juamorenogo/DCSource_DIY/README.md

# EwigVolt - CV/CC Precision DC Supply

---

Electronic design project / UNAL / 2026-1
Project made by:
* Juan Sebastian Moreno Gonzalez
* Nicolás Prieto Solano

## Design Document

It is disposed a PDF file that contains every single detail of the design of this project.
