juamorenogo/DCSource_DIY/Mechanical-design/README.md

# Diseño Electrónico

En esta carpeta se concentran todos los archivos de diseño, excluyendo aquellos destinados a documentación. Estos archivos pueden clasificarse en las siguientes categorías:

- **Simulaciones eléctricas**  
  Archivos de simulación (SPICE, LTspice, etc.) utilizados para validar el comportamiento del circuito.

- **Propuestas de esquemáticos**  
  Diferentes versiones o iteraciones de los diagramas eléctricos del sistema.

- **Diseño de PCB (layout)**  
  Archivos de ruteo, placement, stackup y reglas de diseño (DRC).

- **Pruebas de prototipado y validación**  
  Resultados de mediciones, capturas de osciloscopio, pruebas funcionales y caracterización.

- **Archivos de fabricación**  
  Gerbers, drill files, pick-and-place y BOM final para producción.

- **Librerías de componentes**  
  Símbolos esquemáticos, footprints y modelos asociados.

- **Modelos y simulaciones avanzadas**  
  Modelos SPICE personalizados, simulaciones térmicas y análisis EMI/EMC.

- **Archivos mecánicos asociados**  
  Modelos CAD (STEP, STL) para integración física del diseño.

- **Control de versiones de hardware**  
  Versiones del diseño organizadas por revisiones (Rev A, Rev B, etc.).

- **Archivos de integración hardware–firmware**  
  Mapas de pines, configuraciones de periféricos y definiciones de señales.

- **Análisis de tolerancias y worst-case**  
  Cálculos y simulaciones considerando variaciones de componentes.

- **Estimaciones y diseño de potencia**  
  Análisis de disipación, eficiencia y dimensionamiento de fuentes.

- **Scripts y automatización de diseño**  
  Herramientas para generación de BOM, validaciones y exportaciones automáticas.

Se dispone a continuacion 

---
### V1.0

---
### V1.1

A

---

### V1.2

B

---
