juamorenogo/DCSource_DIY/General-documentation/README.md

# Documentación general.

En esta carpeta, se dispone toda la documentación utilizada durante el proyecto. Desde esquemas prototipos comerciales, hojas de datos de elementos, propuestas similares dadas por otras personas, entre otros.

Así mismo, se dispone la documentación de desarrollo del prototipo. Este documento condensara toda la información necesaria para la construcción de la fuente, los resultados parciales de cada experimento y demás.
