juamorenogo/DCSource_DIY/Electronic-design/General-Design/PCB/03_Power-supply-Flyback/Flyback_PCB_60Hz/3D/2N3906BU.stp

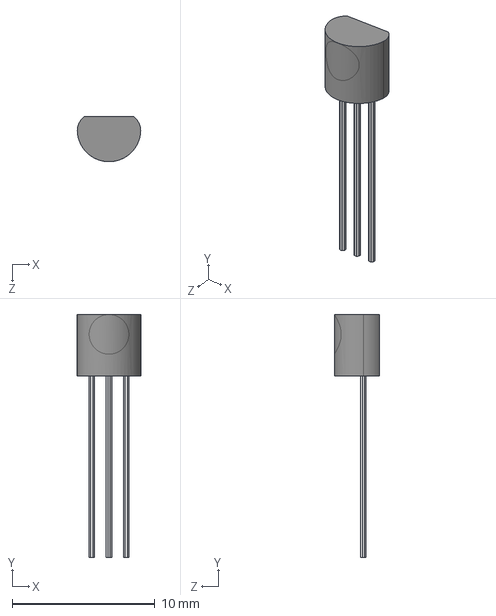
[picture p27: CAD file, 2026-07-27]
Electronic-design/General-Design/PCB/03_Power-supply-Flyback/Flyback_PCB_60Hz/3D/2N3906BU.stp
4.45 x 17.0 x 3.18 mm
