juamorenogo/DCSource_DIY/Electronic-design/General-Design/PCB/03_Power-supply-Flyback/Flyback_PCB_60Hz/3D/Flyback/KBPC610.stp

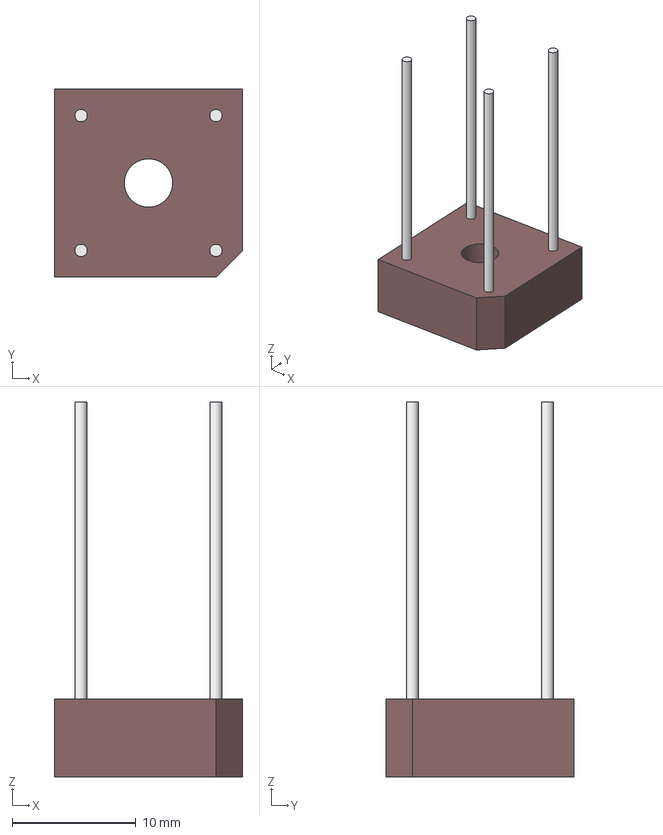
[picture p28: CAD file, 2026-07-27]
Electronic-design/General-Design/PCB/03_Power-supply-Flyback/Flyback_PCB_60Hz/3D/Flyback/KBPC610.stp
15.2 x 15.2 x 30.3 mm
