juamorenogo/DCSource_DIY/Electronic-design/General-Design/PCB/03_Power-supply-Flyback/Flyback_PCB_60Hz/3D/AMRM00101040150MA1.stp

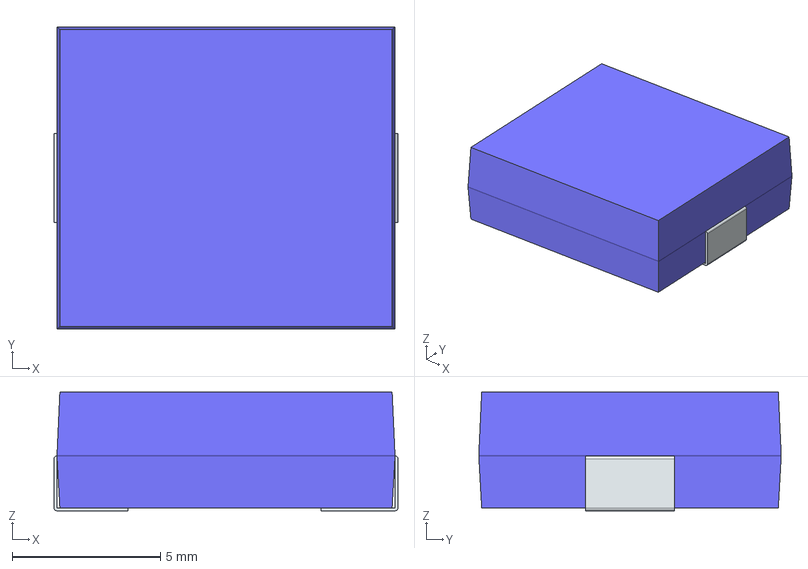
[picture p29: CAD file, 2026-07-12]
Electronic-design/General-Design/PCB/03_Power-supply-Flyback/Flyback_PCB_60Hz/3D/AMRM00101040150MA1.stp
11.6 x 10.2 x 4.00 mm
FilletPin1
FilletPin2
