juamorenogo/DCSource_DIY/Electronic-design/General-Design/PCB/03_Power-supply-Flyback/Flyback_PCB_60Hz/3D/Flyback/TB002-500-02BE.stp

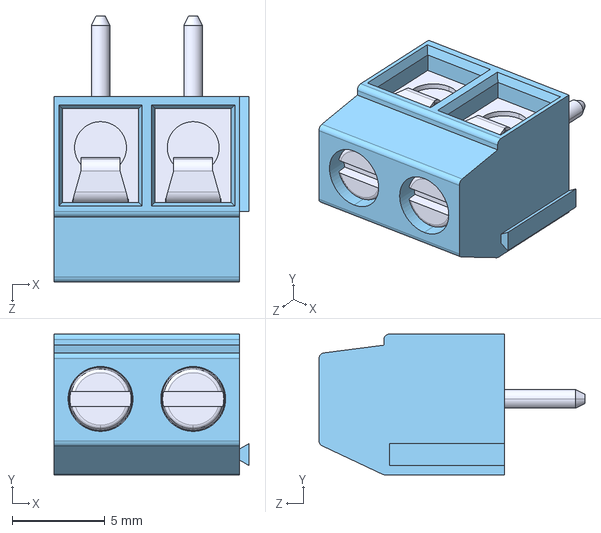
[picture p30: CAD file, 2026-07-27]
Electronic-design/General-Design/PCB/03_Power-supply-Flyback/Flyback_PCB_60Hz/3D/Flyback/TB002-500-02BE.stp
10.5 x 7.60 x 14.4 mm
