juamorenogo/DCSource_DIY/Electronic-design/General-Design/PCB/03_Power-supply-Flyback/Flyback_PCB_60Hz/3D/4300.0104.stp

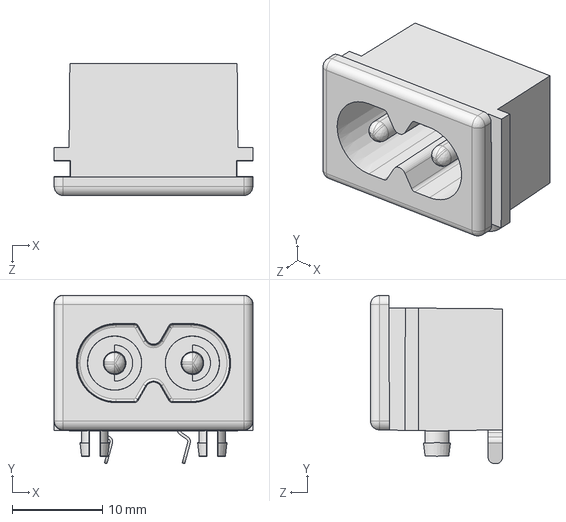
[picture p31: CAD file, 2026-07-12]
Electronic-design/General-Design/PCB/03_Power-supply-Flyback/Flyback_PCB_60Hz/3D/4300.0104.stp
22.0 x 18.6 x 14.6 mm
