juamorenogo/DCSource_DIY/Electronic-design/General-Design/PCB/03_Power-supply-Flyback/Flyback_PCB_60Hz/3D/Flyback/ES3JB-HF.stp

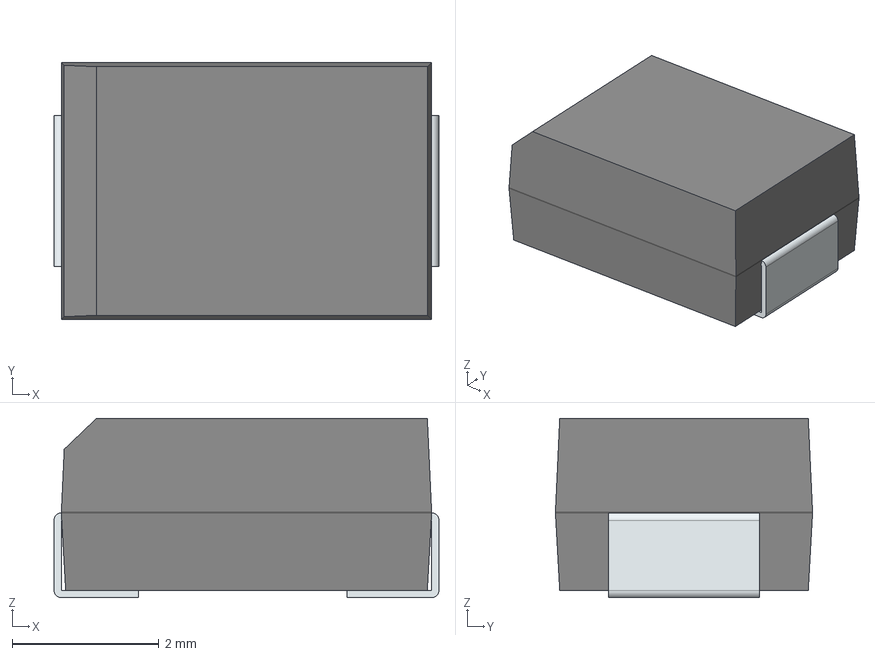
[picture p32: CAD file, 2026-07-27]
Electronic-design/General-Design/PCB/03_Power-supply-Flyback/Flyback_PCB_60Hz/3D/Flyback/ES3JB-HF.stp
5.24 x 3.50 x 2.44 mm
FilletPin1
FilletPin2
