juamorenogo/DCSource_DIY/Electronic-design/General-Design/PCB/03_Power-supply-Flyback/Flyback_PCB_60Hz/3D/Flyback/BFR182E6327HTSA1.stp

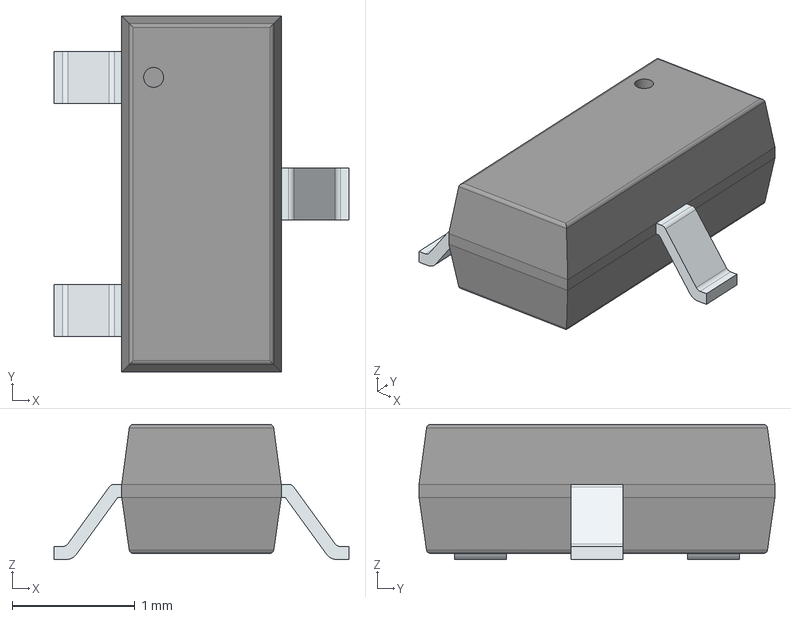
[picture p33: CAD file, 2026-07-27]
Electronic-design/General-Design/PCB/03_Power-supply-Flyback/Flyback_PCB_60Hz/3D/Flyback/BFR182E6327HTSA1.stp
2.40 x 2.90 x 1.10 mm
PinsArrayL
FilletPinR
