juamorenogo/DCSource_DIY/Electronic-design/General-Design/PCB/03_Power-supply-Flyback/Flyback_PCB_60Hz/3D/3FS-324.stp

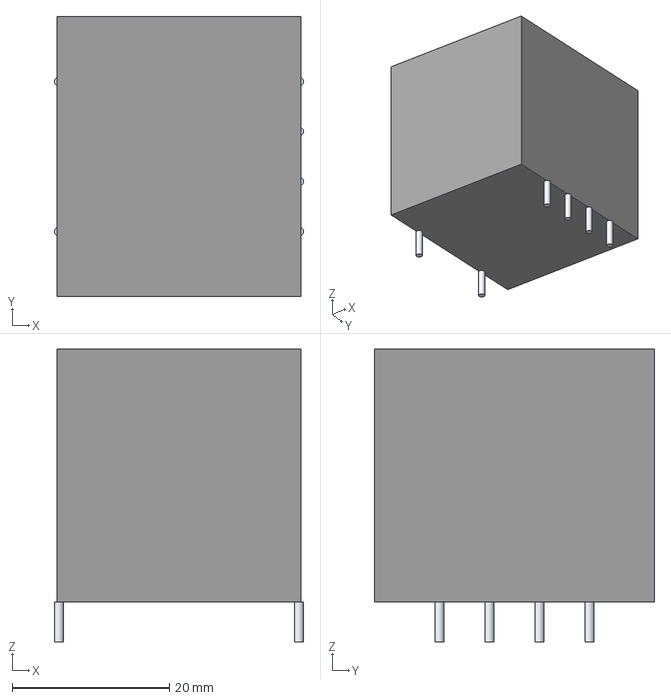
[picture p34: CAD file, 2026-07-12]
Electronic-design/General-Design/PCB/03_Power-supply-Flyback/Flyback_PCB_60Hz/3D/3FS-324.stp
31.6 x 35.6 x 37.2 mm
Leads
