juamorenogo/DCSource_DIY/Electronic-design/General-Design/PCB/03_Power-supply-Flyback/Flyback_PCB_60Hz/3D/Flyback/MPZ1608R391ATD25.stp

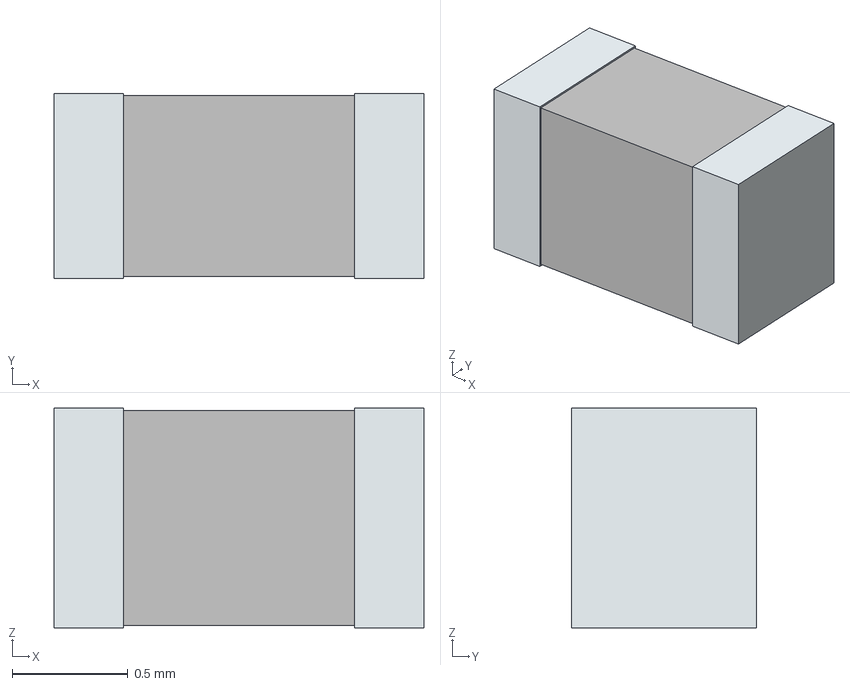
[picture p35: CAD file, 2026-07-23]
Electronic-design/General-Design/PCB/03_Power-supply-Flyback/Flyback_PCB_60Hz/3D/Flyback/MPZ1608R391ATD25.stp
1.60 x 0.8 x 0.95 mm
term1
term2
