juamorenogo/DCSource_DIY/Electronic-design/General-Design/PCB/03_Power-supply-Flyback/Flyback_PCB_60Hz/3D/Flyback/TL431ACLPR.stp

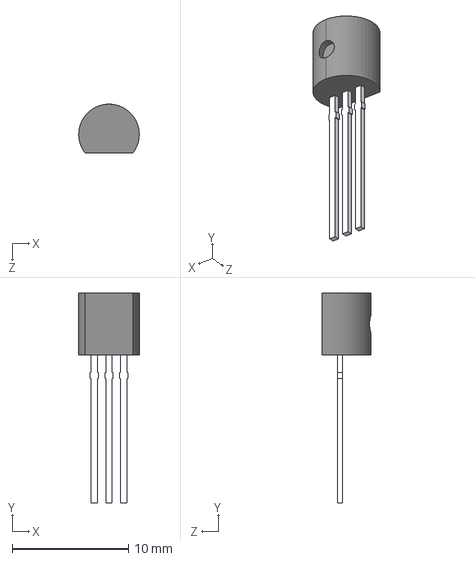
[picture p36: CAD file, 2026-07-23]
Electronic-design/General-Design/PCB/03_Power-supply-Flyback/Flyback_PCB_60Hz/3D/Flyback/TL431ACLPR.stp
5.21 x 18.0 x 4.19 mm
