juamorenogo/DCSource_DIY/Electronic-design/General-Design/PCB/03_Power-supply-Flyback/Flyback_PCB_60Hz/3D/Flyback/UCC38C43DR.stp

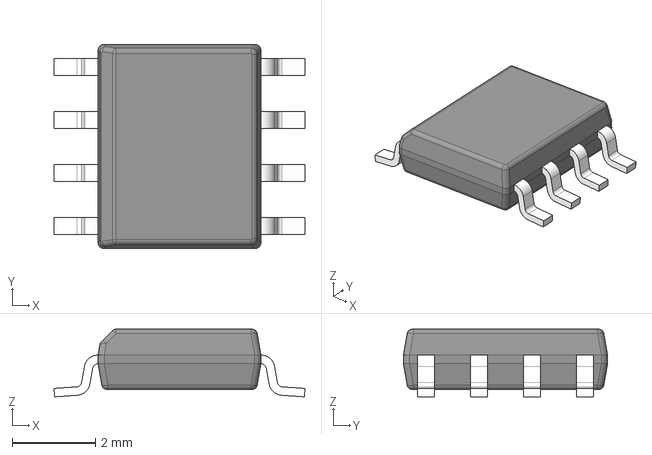
[picture p37: CAD file, 2026-07-23]
Electronic-design/General-Design/PCB/03_Power-supply-Flyback/Flyback_PCB_60Hz/3D/Flyback/UCC38C43DR.stp
6.02 x 4.90 x 1.63 mm
BODY-SO
LEAD-D0008A x 8
