juamorenogo/DCSource_DIY/Electronic-design/General-Design/PCB/03_Power-supply-Flyback/Flyback_PCB_60Hz/3D/Flyback/CSRN2512FKR250.stp

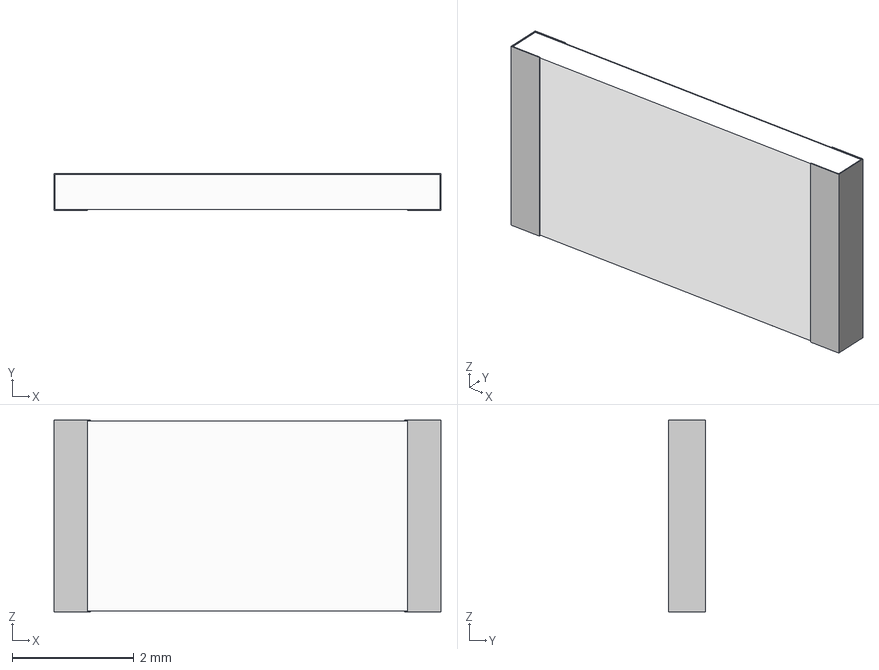
[picture p38: CAD file, 2026-07-23]
Electronic-design/General-Design/PCB/03_Power-supply-Flyback/Flyback_PCB_60Hz/3D/Flyback/CSRN2512FKR250.stp
6.35 x 0.6 x 3.15 mm
