juamorenogo/DCSource_DIY/Electronic-design/General-Design/PCB/03_Power-supply-Flyback/Flyback_PCB_60Hz/3D/Flyback/DPC817L-A-TR.stp

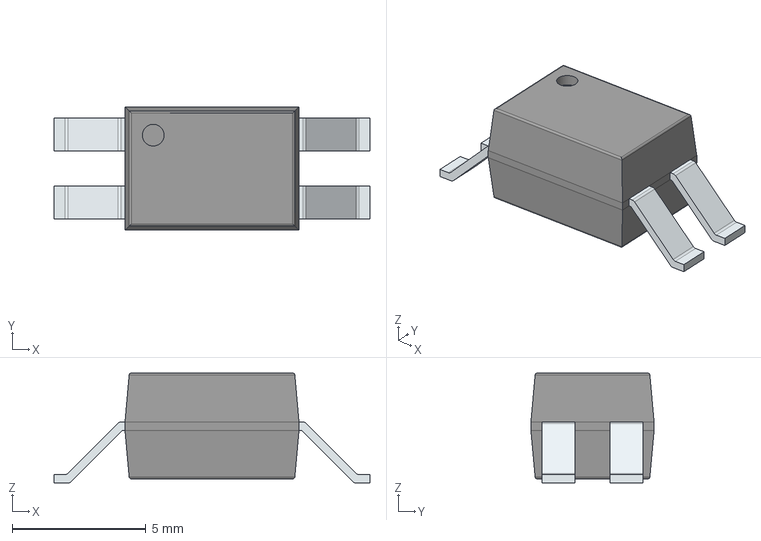
[picture p39: CAD file, 2026-07-23]
Electronic-design/General-Design/PCB/03_Power-supply-Flyback/Flyback_PCB_60Hz/3D/Flyback/DPC817L-A-TR.stp
11.8 x 4.60 x 4.10 mm
PinsArrayLR
