juamorenogo/DCSource_DIY/Electronic-design/General-Design/PCB/03_Power-supply-Flyback/Flyback_PCB_60Hz/3D/TPS54302DDCR.stp

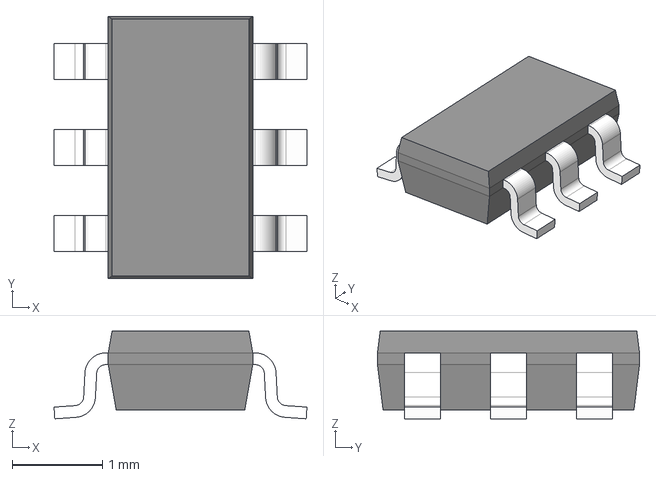
[picture p41: CAD file, 2026-07-12]
Electronic-design/General-Design/PCB/03_Power-supply-Flyback/Flyback_PCB_60Hz/3D/TPS54302DDCR.stp
2.80 x 2.90 x 0.97 mm
BODY-SOT
LEAD-SOT x 6
