juamorenogo/DCSource_DIY/Electronic-design/General-Design/PCB/03_Power-supply-Flyback/Flyback_PCB_60Hz/3D/Flyback/750811351.stp

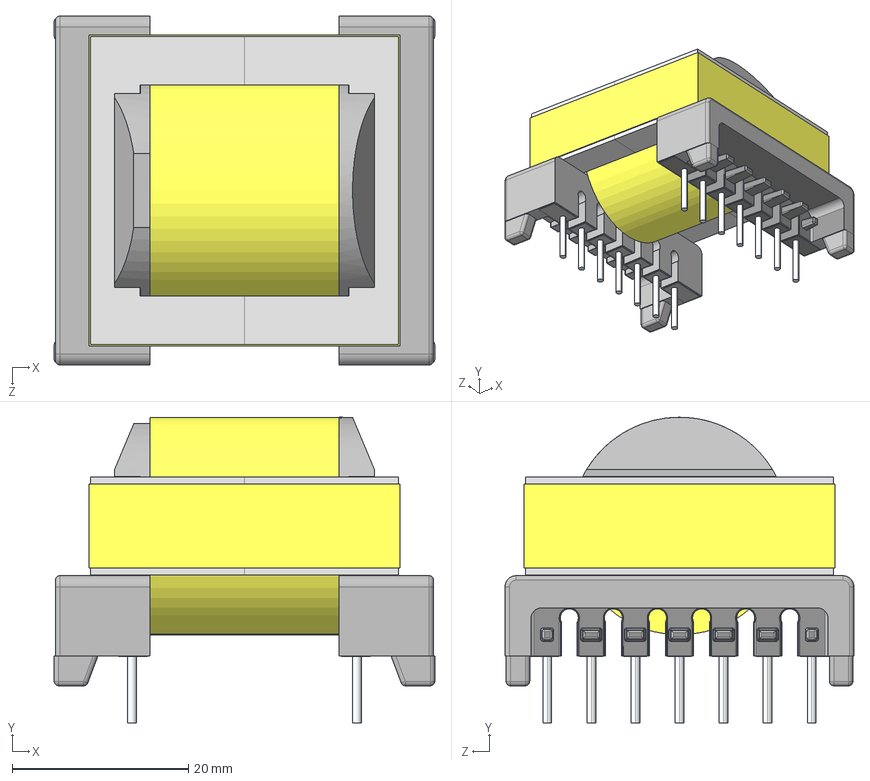
[picture p42: CAD file, 2026-07-23]
Electronic-design/General-Design/PCB/03_Power-supply-Flyback/Flyback_PCB_60Hz/3D/Flyback/750811351.stp
43.2 x 34.7 x 39.6 mm
070-5455_6C
070-5455_coil
150-0897_6C x 2
