juamorenogo/DCSource_DIY/Electronic-design/General-Design/PCB/02_Power-supply/PCB60hz_15/PCB60hz_15-B_Cu.pdf

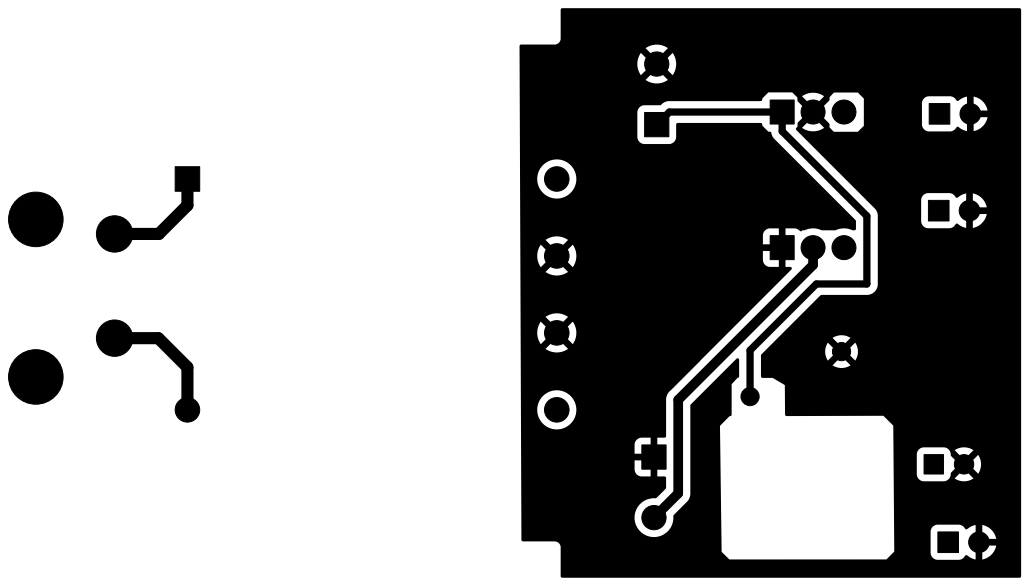
[picture p43: page 1]
