juamorenogo/DCSource_DIY/Electronic-design/General-Design/PCB/02_Power-supply/PCB60hz_15/PCB60hz_15-Edge_Cuts.pdf

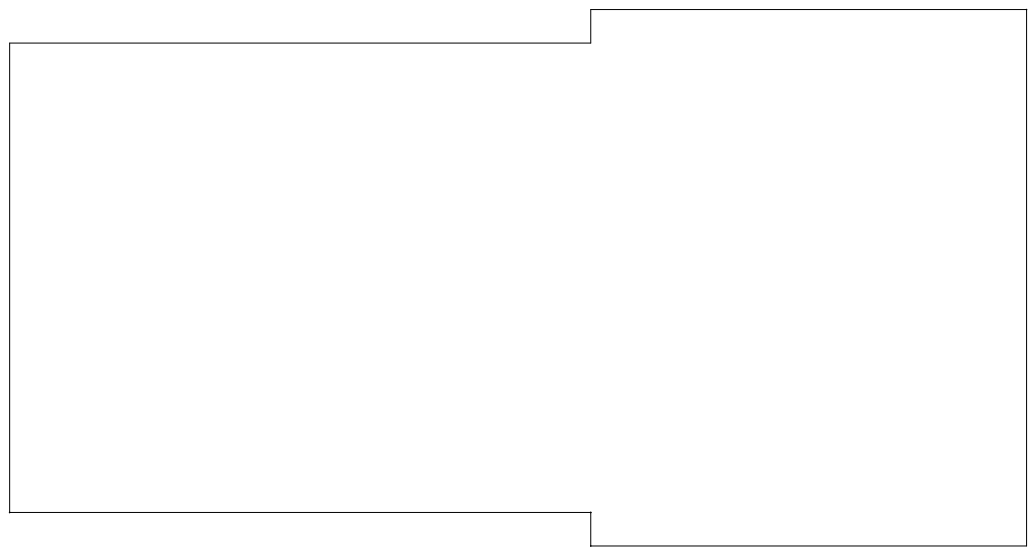
[picture p44: page 1]
