juamorenogo/DCSource_DIY/Electronic-design/General-Design/PCB/02_Power-supply/PCB60hz_15/PCB60hz_15-F_Cu.pdf

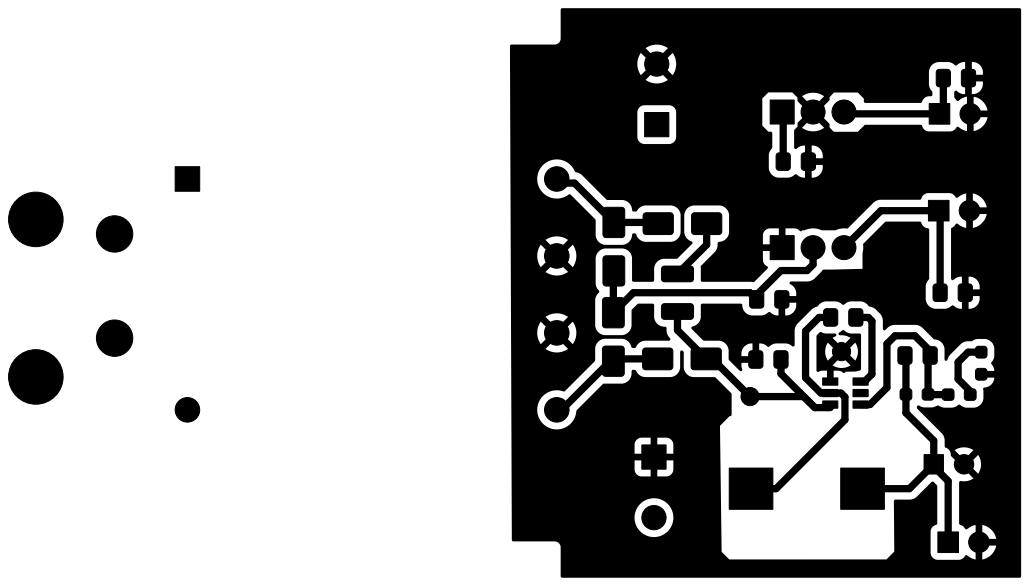
[picture p45: page 1]
