juamorenogo/DCSource_DIY/Electronic-design/General-Design/PCB/02_Power-supply/PCB60hz_15/PCB60hz_15-F_Silkscreen.pdf

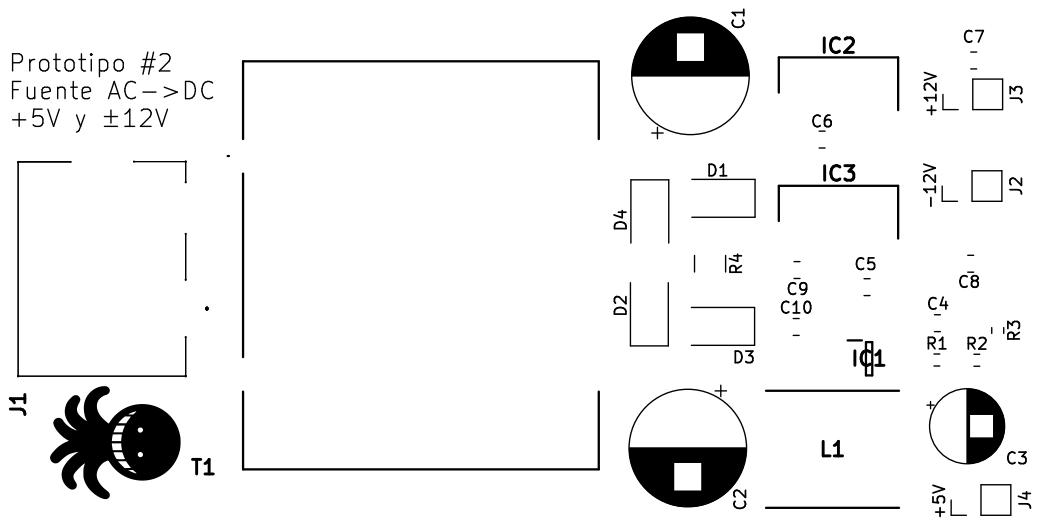
[picture p46: page 1]
