juamorenogo/DCSource_DIY/Electronic-design/General-Design/PCB/02_Power-supply/PCB60hz_15/PCB60hz_15.pdf

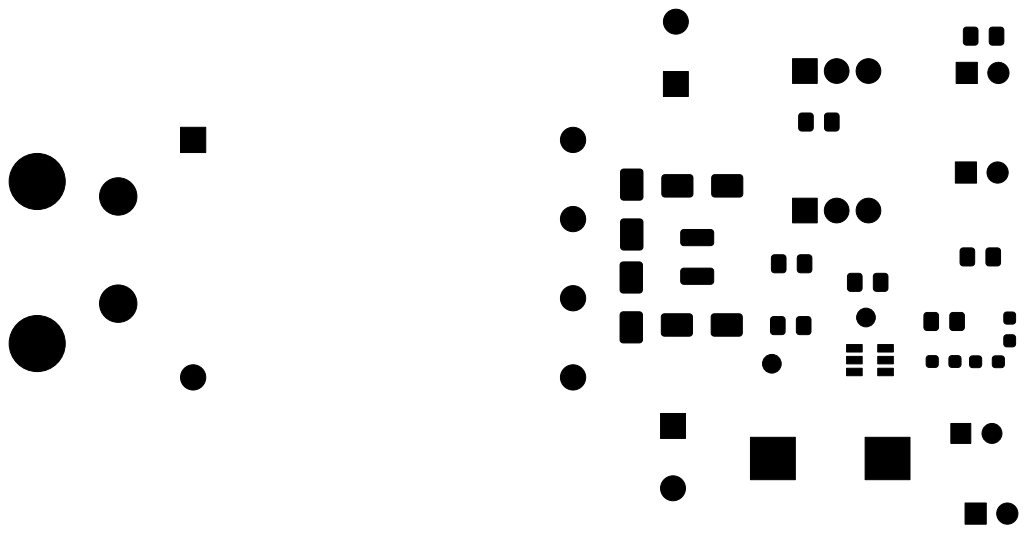
[picture p47: page 1]

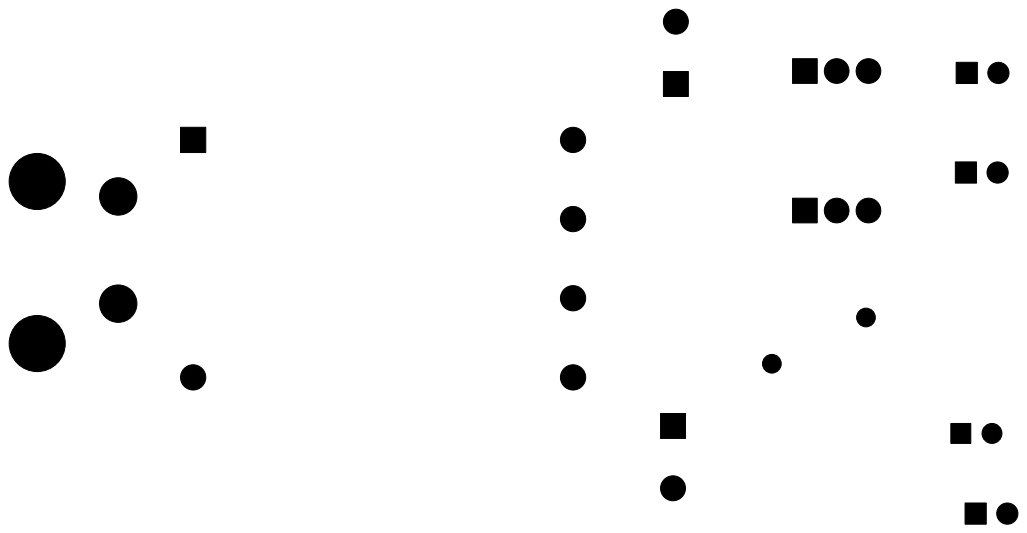
[picture p48: page 2]
