juamorenogo/DCSource_DIY/Electronic-design/Stage-by-stage-design/00_DC-DC_Converter/LTSpice-simulation/Draft1.asc

C1: cap
D1: diode
R1: res
R2: res
R_var: res
U1: TRIAC
U2: PC817B
V1: voltage; SINE(0 15 60)
V2: voltage
