juamorenogo/DCSource_DIY/Electronic-design/Stage-by-stage-design/00_DC-DC_Converter/LTSpice-simulation/TestSim_1.asc

C1: cap; 440µ
C2: cap; 1µ
C3: cap; 10n
C4: cap; 10n
C5: cap; 100p
C6: cap; 2.2n
C7: cap; 0.1µ
C8: cap; 120µ
C9: cap; 0.1µ
C10: cap; 579µ
C11: cap; 0.01µ
C12: cap; 10n
D1: diode; 1N4007
D2: diode; 1N4007
D3: diode; 1N4007
D4: diode; 1N4007
D5: diode; MURS120
D6: zener; D815J
D7: diode; MBR745
D8: zener; D814V
D9: diode; BYW96E
D10: diode
L1: ind2; 4.2m
L2: ind2; 11.28µ
L3: ind2; 61.43µ
M1: nmos; STD12N50DM2_AB
Q1: npn
Q2: pnp
R1: res; 100k
R2: res; 6.67k
R3: res; 24.9K
R4: res; 10k
R5: res; 8k
R6: res; 1k
R7: res; 4.99k
R8: res; 3.8k
R9: res; 100
R10: res; 10
R11: res; 10k
R12: res; 0.75
R13: res; 22
R14: res; 1.3k
R15: res; 1k
R16: res; 9.53k
R17: res; 88.7
R18: res; 2.49k
R19: res; 50k
R20: res; 1Meg
R21: res; 1Meg
R22: res; 100k
U1: UCC28C43_STEADY2
U2: 4N25
U3: TL431
V1: voltage; 15
V2: voltage; SINE(0 170 60)
Named nets: 0, VRef, Vout, GND2
Lazo de sensado a la salida
Entrada AC --> Rectificacion con C Bulk
VDD para IC
Flyback
Secundario y Salida DC
IC driver
VDD
Library
Resistencias como posibles trimmers:
R10
R13
R2
Revisar como calcular:
 
C3 y R3
C12 y R19
.lib FirstOrdergenericSCR.lib
K1 L1 L2 L3 0.99
Configuracion de Simulacion
.option noopiter
.tran 0 200m startup
