juamorenogo/DCSource_DIY/Electronic-design/Stage-by-stage-design/00_DC-DC_Converter/LTSpice-simulation/Sim_1.asc

C1: cap; 440µ
C2: cap; 1µ
C3: cap; 10n
C4: cap
C5: cap
C6: cap; 2.2n
C7: cap; 0.1µ
C8: cap; 120µ
C9: cap; 0.1µ
C10: cap; 579µ
C11: cap
C12: cap; 10n
D1: diode
D2: diode
D3: diode
D4: diode
D5: diode
D6: zener; UDZV10B
D7: diode
D8: diode
D9: diode
D10: diode
L1: ind; 4.2m
L2: ind; 11.28µ
L3: ind; 61.43µ
M1: nmos
Q1: npn
Q2: pnp
R1: res; 420k
R2: res; 6.67k
R3: res; 24.9K
R4: res
R5: res; 8k
R6: res
R7: res
R8: res
R9: res
R10: res; 10
R11: res; 10k
R12: res; 0.75
R13: res; 22
R14: res
R15: res
R16: res
R17: res
R18: res
R19: res; 50k
U1: UCC28C43_STEADY2
U2: 4N25
U3: SCR
V2: voltage; SINE(0 170 60)
Named nets: 0, VRef, Vout, COM
.tran 10m
.include UCC28C43_LTspice_Compatible_v2.lib
Lazo de sensado a la salida
Entrada AC --> Rectificacion con C Bulk
VDD para IC
Flyback
Secundario y Salida DC
IC driver
VDD
.inc thyristr.lin
Library
Resistencias como posibles trimmers:
R10
R13
R2
Revisar como calcular:
 
C3 y R3
C12 y R19
