juamorenogo/DCSource_DIY/Electronic-design/Stage-by-stage-design/00_DC-DC_Converter/LTSpice-simulation/TestIC/Draft2.asc

C1: cap; 10.41µ
D1: diode; Diode_nom
L1: ind; 781.25µ; Rser=0.2
R1: res; 20
S1: sw; SW_ideal
V1: voltage; 18
V2: voltage; PULSE(0 15 0 1n 1n {T_on} 16.6667u)
Named nets: 0, Vout, Vs
.tran 0 5m 4900u
.model SW_IDEAL SW(Ron=1u Roff=1G Vt=2 Vh=0)
.step param T_on 1.667u 13.333u 0.8333u
.meas TRAN Vout1 AVG V(Vout) FROM 0 TO 100u
