juamorenogo/DCSource_DIY/Electronic-design/Stage-by-stage-design/00_DC-DC_Converter/LTSpice-simulation/TestIC/Draft1.asc

D1: diode
D2: diode
D3: diode
D4: diode
R1: res; 100
R2: res; 100
V1: voltage; SINE(0 20 60)
V2: voltage; SINE(0 20 60)
Named nets: 0, V+, V-
.tran 100m
