juamorenogo/DCSource_DIY/Electronic-design/Stage-by-stage-design/00_DC-DC_Converter/LTSpice-simulation/TestIC/Test_IC.asc

C1: cap; 2.2n
C2: cap; 10n
R1: res; 8k
R2: res; 2.5k
R3: res; 100
R4: res; 10k
R5: res; 1Meg
U1: UCC28C43_STEADY2
V1: voltage; 15
Named nets: 0, Vr, Vout
.tran 500m
