juamorenogo/DCSource_DIY/(list of files, drawings)

Other design files:
Electronic-design/General-Design/PCB/01_Digital-interface/Prototype_0THT/Digital_Interface/freerouting.dsn
Electronic-design/General-Design/PCB/01_Digital-interface/Prototype_0THT/Digital_Interface/temp-freerouting.dsn
Electronic-design/General-Design/PCB/03_Power-supply-Flyback/Flyback_PCB_60Hz/freerouting.dsn
Electronic-design/General-Design/PCB/03_Power-supply-Flyback/Flyback_PCB_60Hz/temp-freerouting.dsn
Electronic-design/Stage-by-stage-design/01_Digital-interface/Protheus_simulation/Digital_simulation.pdsprj
