juamorenogo/DCSource_DIY/Electronic-design/General-Design/PCB/03_Power-supply-Flyback/Flyback_PCB_60Hz/Flyback_PCB_60Hz.kicad_pcb

## KiCad design Electronic-design/General-Design/PCB/03_Power-supply-Flyback/Flyback_PCB_60Hz/Flyback_PCB_60Hz.kicad_pcb (2026-07-29)

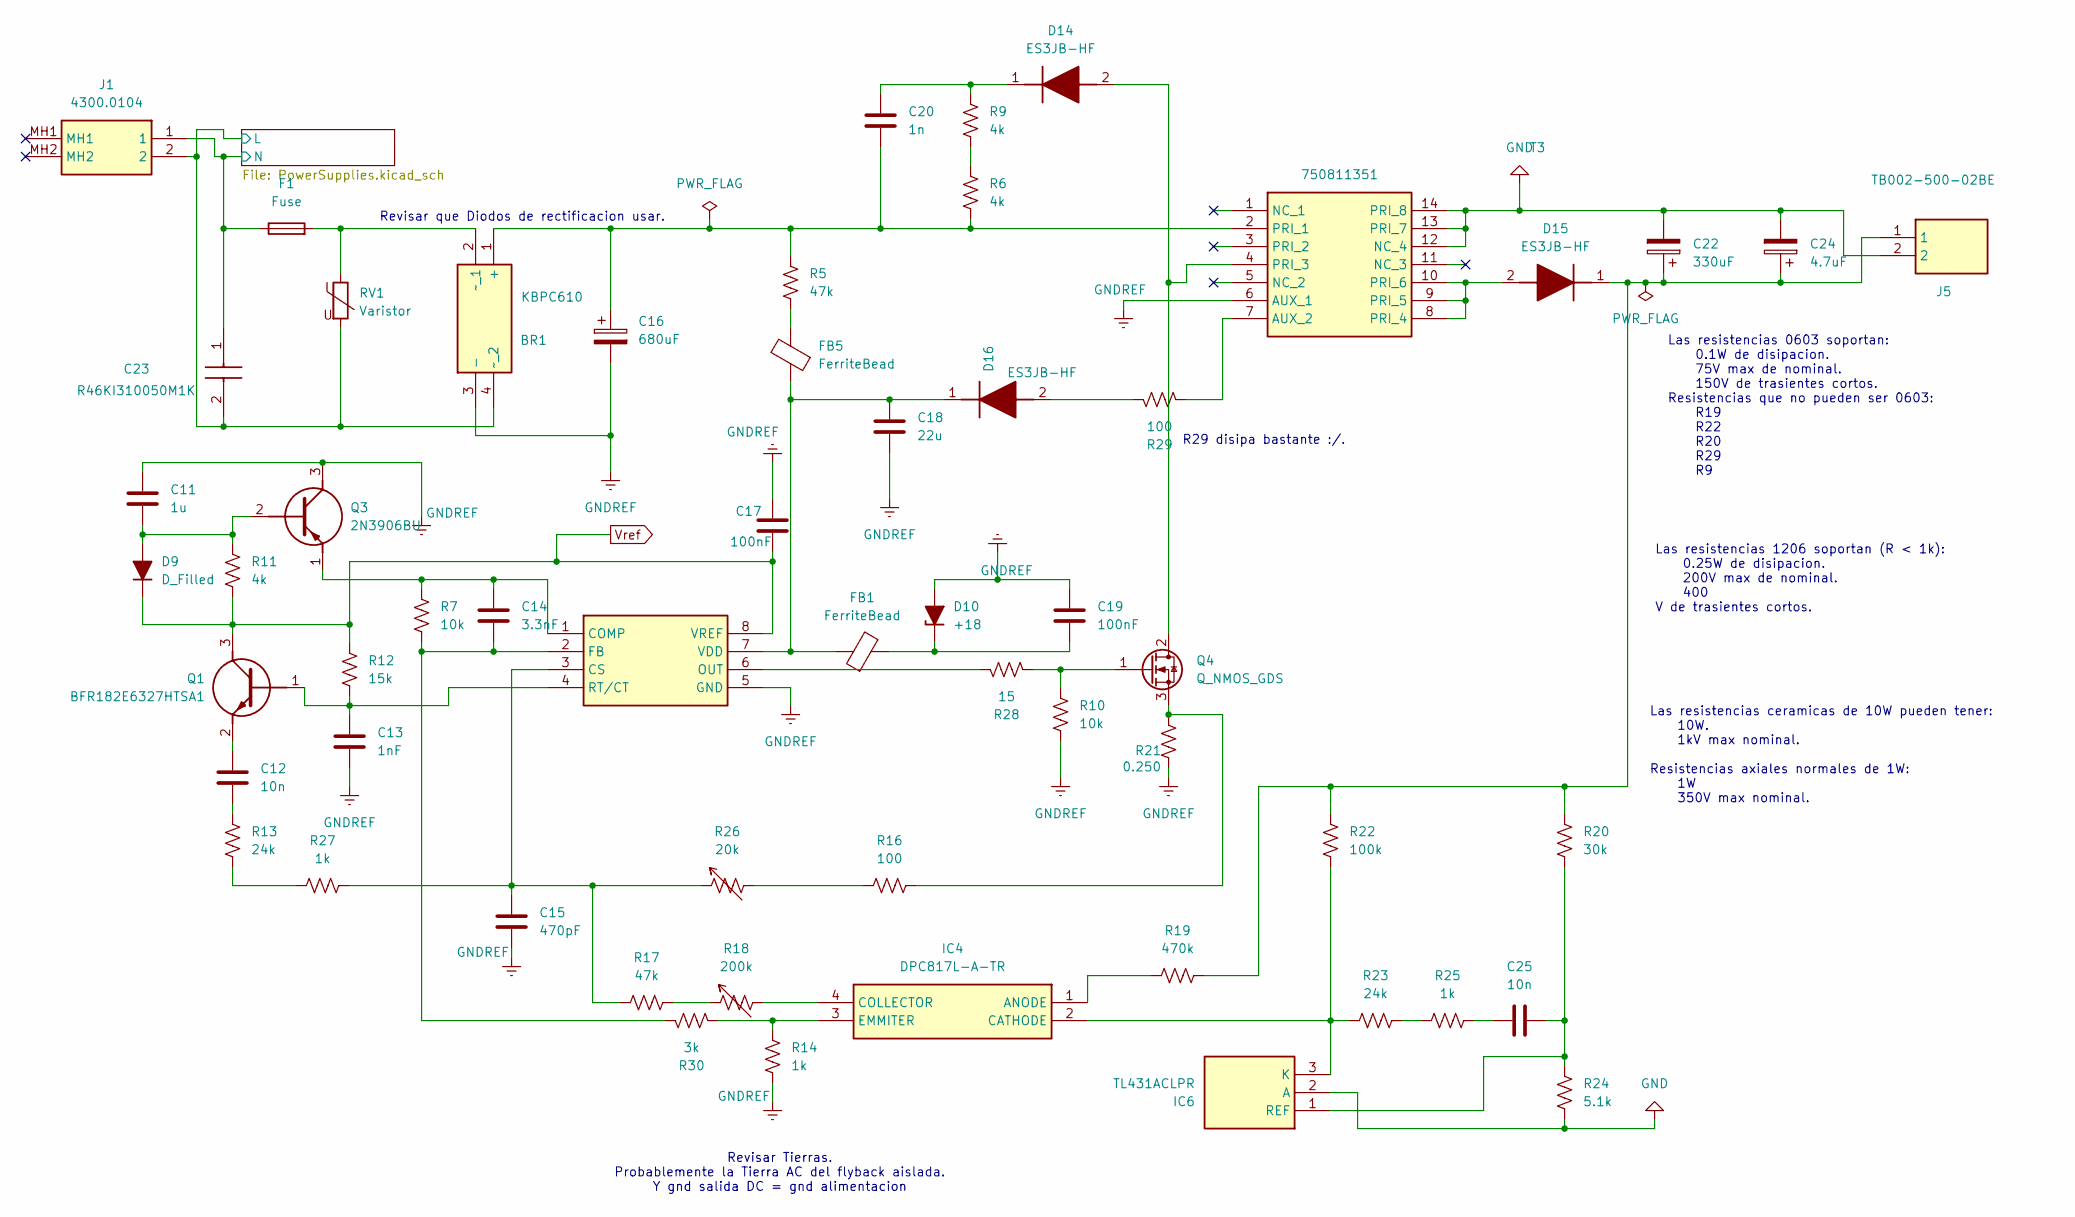
[picture p49: schematic Flyback_PCB_60Hz.kicad_sch]

Parts:
BR1: KBPC610; Mouser Part Number 637-KBPC610
C11: 1u; C_0805_2012Metric_Pad1.18x1.45mm_HandSolder
C12, C25: 10n; C_0805_2012Metric_Pad1.18x1.45mm_HandSolder
C13: 1nF; C_0805_2012Metric_Pad1.18x1.45mm_HandSolder
C14: 3.3nF; C_0805_2012Metric_Pad1.18x1.45mm_HandSolder
C15: 470pF; C_0805_2012Metric_Pad1.18x1.45mm_HandSolder
C16: 680uF; CP_Radial_D10.0mm_P5.00mm
C17, C19: 100nF; C_0805_2012Metric_Pad1.18x1.45mm_HandSolder
C18: 22u; CP_Radial_Tantal_D6.0mm_P2.50mm
C20: 1n; C_Disc_D7.5mm_W4.4mm_P5.00mm
C22: 330uF; CP_Radial_D18.0mm_P7.50mm
C23: R46KI310050M1K; Mouser Part Number 80-R46KI310050M1K
C24: 4.7uF; CP_Radial_D10.0mm_P5.00mm
D9: D_Filled; D_SMA_Handsoldering
D10: +18; D_DO-41_SOD81_P10.16mm_Horizontal
D14, D15, D16: ES3JB-HF; DIOM5235X244N; Mouser Part Number 750-ES3JB-HF
F1: Fuse; Fuseholder_Cylinder-5x20mm_Schurter_0031_8201_Horizontal_Op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
FB1, FB5: FerriteBead; BEADC1608X95N
IC4: DPC817L-A-TR; SOP254P1180X410-4N; Manufacturer_Part_Number DPC817L-A-TR
IC5: UCC38C43DR; SOIC127P600X175-8N; Mouser Part Number 595-UCC38C43DR
IC6: TL431ACLPR; Mouser Part Number 595-TL431ACLPR
J1: 4300.0104; 43000104; Mouser Part Number 693-4300.0104
J5: TB002-500-02BE; Mouser Part Number 490-TB002-500-02BE
Q1: BFR182E6327HTSA1; NPN_SOT95P240X110-3N; Manufacturer_Part_Number BFR182E6327HTSA1
Q3: 2N3906BU; Mouser Part Number 512-2N3906BU
Q4: Q_NMOS_GDS; TO-220F-3_Vertical
R5, R17: 47k; R_0603_1608Metric_Pad0.98x0.95mm_HandSolder
R6, R9: 4k; R_Axial_Power_L20.0mm_W6.4mm_P25.40mm
R7, R10: 10k; R_0603_1608Metric_Pad0.98x0.95mm_HandSolder
R11: 4k; R_0603_1608Metric_Pad0.98x0.95mm_HandSolder
R12: 15k; R_0603_1608Metric_Pad0.98x0.95mm_HandSolder
R13, R23: 24k; R_0603_1608Metric_Pad0.98x0.95mm_HandSolder
R14, R25, R27: 1k; R_0603_1608Metric_Pad0.98x0.95mm_HandSolder
R16: 100; R_1206_3216Metric_Pad1.30x1.75mm_HandSolder
R18: 200k; Potentiometer_Bourns_3296W_Vertical
R19: 470k; R_1206_3216Metric_Pad1.30x1.75mm_HandSolder
R20: 30k; R_Axial_DIN0414_L11.9mm_D4.5mm_P15.24mm_Horizontal
R21: 0.250; RESC6432X70N
R22: 100k; R_Axial_DIN0414_L11.9mm_D4.5mm_P15.24mm_Horizontal
R24: 5.1k; R_1206_3216Metric_Pad1.30x1.75mm_HandSolder
R26: 20k; Potentiometer_Bourns_3296W_Vertical
R28: 15; R_1206_3216Metric_Pad1.30x1.75mm_HandSolder
R29: 100; R_Axial_DIN0414_L11.9mm_D4.5mm_P15.24mm_Horizontal
R30: 3k; R_0603_1608Metric_Pad0.98x0.95mm_HandSolder
RV1: Varistor; RV_Disc_D15.5mm_W4.4mm_P7.5mm
T3: 750811351; Mouser Part Number 710-750811351

Connections:
/Supplies/L: BR1.4 (~_2), C23.2, J1.2, RV1.2; also elsewhere on the board
/Supplies/N: C23.1, F1.1, J1.1; also elsewhere on the board
GND: C22.2, C24.2, IC6.2 (A), J5.2, R24.2, T3.12 (NC_4), T3.13 (PRI_7), T3.14 (PRI_8); also elsewhere on the board
GNDREF: BR1.3 (-), C11.1, C13.2, C15.2, C16.2, C17.1, C18.2, C19.1, D10.2 (A), IC5.5 (GND), Q3.3 (C), R10.2, R14.2, R21.2, T3.6 (AUX_1)
unnamed: BR1.1 (+), C16.1, C20.2, R5.1, R6.2, T3.2 (PRI_1)
unnamed: BR1.2 (~_1), F1.2, RV1.1
unnamed: C12.2, R13.1
unnamed: C25.2, R25.1
unnamed: C11.2, D9.2 (A), Q3.2 (B), R11.1
unnamed: C19.2, D10.1 (K), FB1.2
unnamed: D14.2 (A), Q4.2 (D), T3.4 (PRI_3)
unnamed: C20.1, D14.1 (K), R9.1
unnamed: D15.2 (A), T3.8 (PRI_4), T3.9 (PRI_5), T3.10 (PRI_6)
unnamed: C22.1, C24.1, D15.1 (K), J5.1, R19.1, R20.1, R22.2
unnamed: D16.2 (A), R29.1
unnamed: C18.1, D16.1 (K), FB1.1, FB5.1, IC5.7 (VDD)
unnamed: FB5.2, R5.2
unnamed: IC4.1 (ANODE), R19.2
unnamed: IC4.2 (CATHODE), IC6.3 (K), R22.1, R23.2
unnamed: IC4.4 (COLLECTOR), R18.2
unnamed: IC4.3 (EMMITER), R14.1, R30.2
unnamed: C14.1, IC5.1 (COMP), Q3.1 (E), R7.1
unnamed: C15.1, IC5.3 (CS), R17.1, R26.1, R27.2
unnamed: C14.2, IC5.2 (FB), R7.2, R30.1
unnamed: IC5.6 (OUT), R28.1
unnamed: C13.1, IC5.4 (RT/CT), Q1.1 (B), R12.2
unnamed: C25.1, IC6.1 (REF), R20.2, R24.1
unnamed: C12.1, Q1.2 (E)
unnamed: Q4.1 (G), R10.1, R28.2
unnamed: Q4.3 (S), R16.2, R21.1
unnamed: R6.1, R9.2
unnamed: R13.2, R27.1
unnamed: R16.1, R26.2
unnamed: R17.2, R18.1
unnamed: R23.1, R25.2
unnamed: R29.2, T3.7 (AUX_2)
Vref: C17.2, D9.1 (K), IC5.8 (VREF), Q1.3 (C), R11.2, R12.1

Notes on the sheet:
Las resistencias 1206 soportan (R < 1k): 0.25W de disipacion. 200V max de nominal. 400 V de trasientes cortos.
Revisar Tierras. Probablemente la Tierra AC del flyback aislada. Y gnd salida DC = gnd alimentacion
Las resistencias ceramicas de 10W pueden tener: 10W. 1kV max nominal. Resistencias axiales normales de 1W: 1W 350V max nominal.
R29 disipa bastante :/.
Las resistencias 0603 soportan: 0.1W de disipacion. 75V max de nominal. 150V de trasientes cortos. Resistencias que no pueden ser 0603: R19 R22 R20 R29 R9
Revisar que Diodos de rectificacion usar.

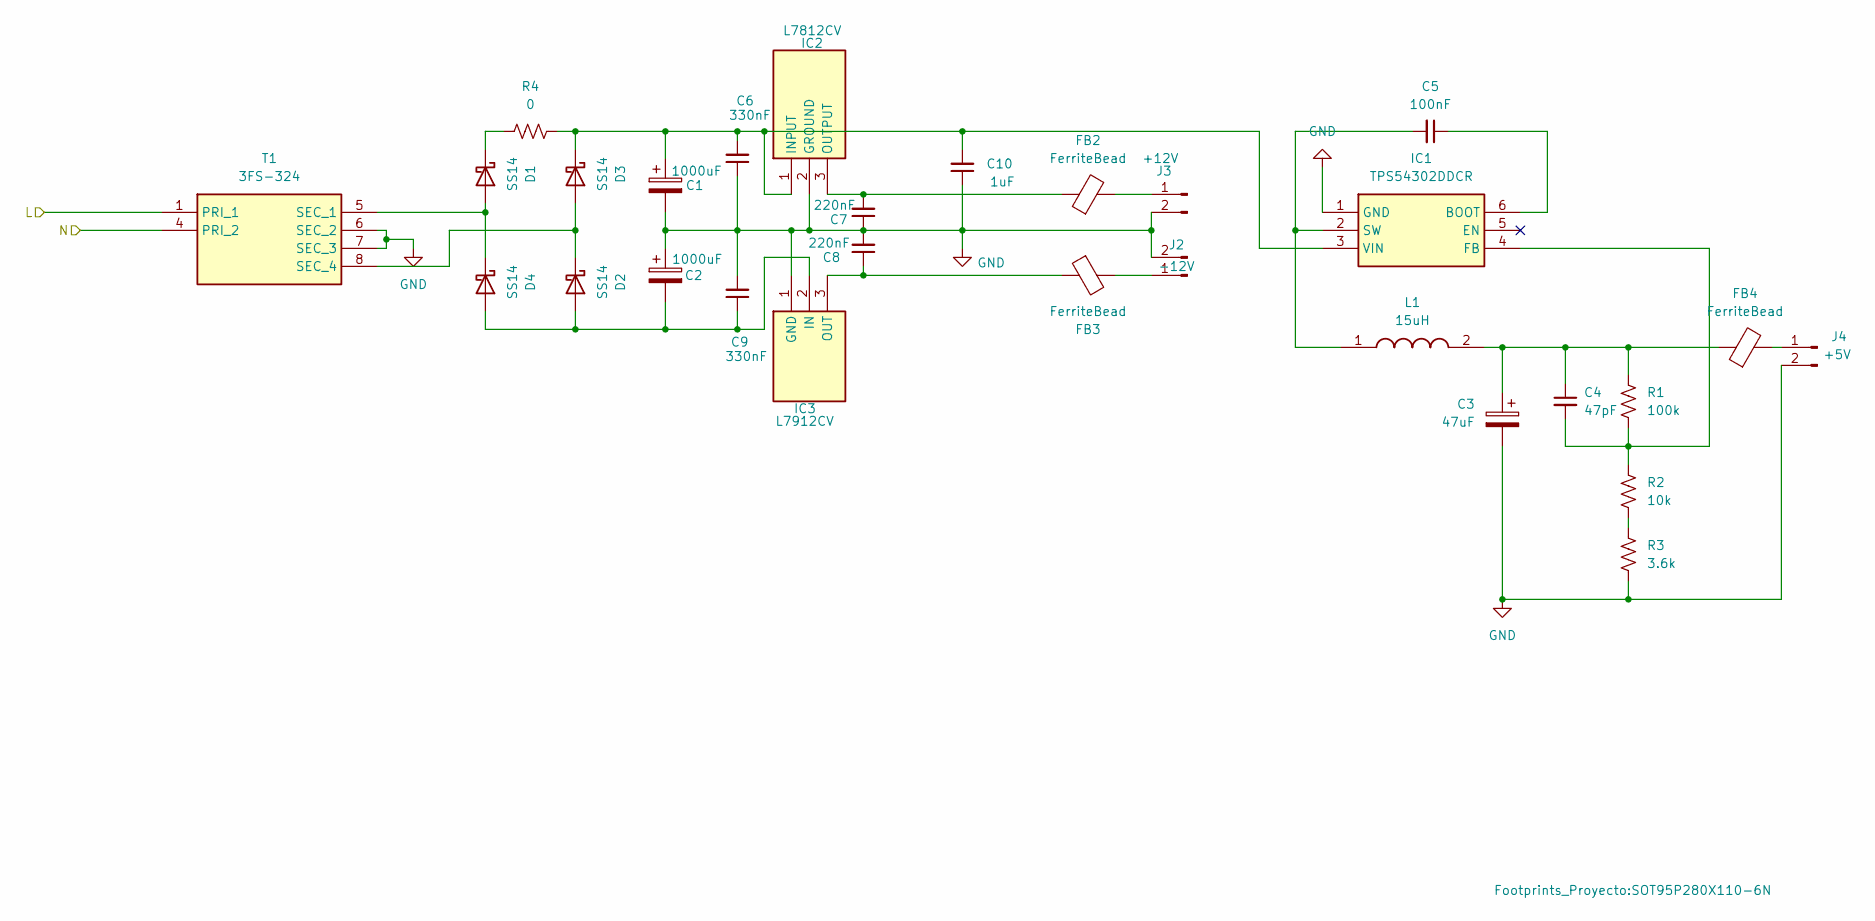
[picture p50: schematic PowerSupplies.kicad_sch]

Parts:
C1, C2: 1000uF; CP_Radial_D10.0mm_P5.00mm
C3: 47uF; CP_Radial_D6.3mm_P2.50mm
C4: 47pF; C_0805_2012Metric_Pad1.18x1.45mm_HandSolder
C5: 100nF; C_0805_2012Metric_Pad1.18x1.45mm_HandSolder
C6, C9: 330nF; C_0805_2012Metric_Pad1.18x1.45mm_HandSolder
C7, C8: 220nF; C_0805_2012Metric_Pad1.18x1.45mm_HandSolder
C10: 1uF; C_0805_2012Metric_Pad1.18x1.45mm_HandSolder
D1, D2, D3, D4: SS14; D_SMA
FB2, FB3, FB4: FerriteBead; BEADC1608X95N
IC1: TPS54302DDCR; SOT95P280X110-6N; Mouser Part Number 595-TPS54302DDCR
IC2: L7812CV; L8_TO255P460X1020X2008-3P; Mouser Part Number 511-L7812CV
IC3: L7912CV; L9_TO255P460X1020X2008-3P; Mouser Part Number 511-L7912CV
J2: -12V; PinHeader_1x02_P2.54mm_Vertical
J3: +12V; PinHeader_1x02_P2.54mm_Vertical
J4: +5V; PinHeader_1x02_P2.54mm_Vertical
L1: 15uH; INDPM116102X400N; Manufacturer_Part_Number AMRM00101040150MA1
R1: 100k; R_0603_1608Metric_Pad0.98x0.95mm_HandSolder
R2: 10k; R_0603_1608Metric_Pad0.98x0.95mm_HandSolder
R3: 3.6k; R_0603_1608Metric_Pad0.98x0.95mm_HandSolder
R4: 0; R_1210_3225Metric_Pad1.30x2.65mm_HandSolder
T1: 3FS-324; 3FS324; Mouser Part Number 838-3FS-324

Connections:
/Supplies/L: T1.1 (PRI_1); also elsewhere on the board
/Supplies/N: T1.4 (PRI_2); also elsewhere on the board
GND: C1.2, C2.1, C3.2, C6.1, C7.1, C8.2, C9.2, C10.1, IC1.1 (GND), IC2.2 (GROUND), IC3.1 (GND), J2.2, J3.2, J4.2, R3.2, T1.6 (SEC_2), T1.7 (SEC_3); also elsewhere on the board
unnamed: C3.1, C4.1, FB4.1, L1.2, R1.1
unnamed: D1.2 (A), D4.1 (K), T1.5 (SEC_1)
unnamed: D1.1 (K), R4.1
unnamed: C2.2, C9.1, D2.2 (A), D4.2 (A), IC3.2 (IN)
unnamed: D2.1 (K), D3.2 (A), T1.8 (SEC_4)
unnamed: C1.1, C6.2, C10.2, D3.1 (K), IC1.3 (VIN), IC2.1 (INPUT), R4.2
unnamed: C5.1, IC1.6 (BOOT)
unnamed: C4.2, IC1.4 (FB), R1.2, R2.1
unnamed: C5.2, IC1.2 (SW), L1.1
unnamed: C7.2, FB2.1, IC2.3 (OUTPUT)
unnamed: C8.1, FB3.1, IC3.3 (OUT)
unnamed: FB3.2, J2.1
unnamed: FB2.2, J3.1
unnamed: FB4.2, J4.1
unnamed: R2.2, R3.1

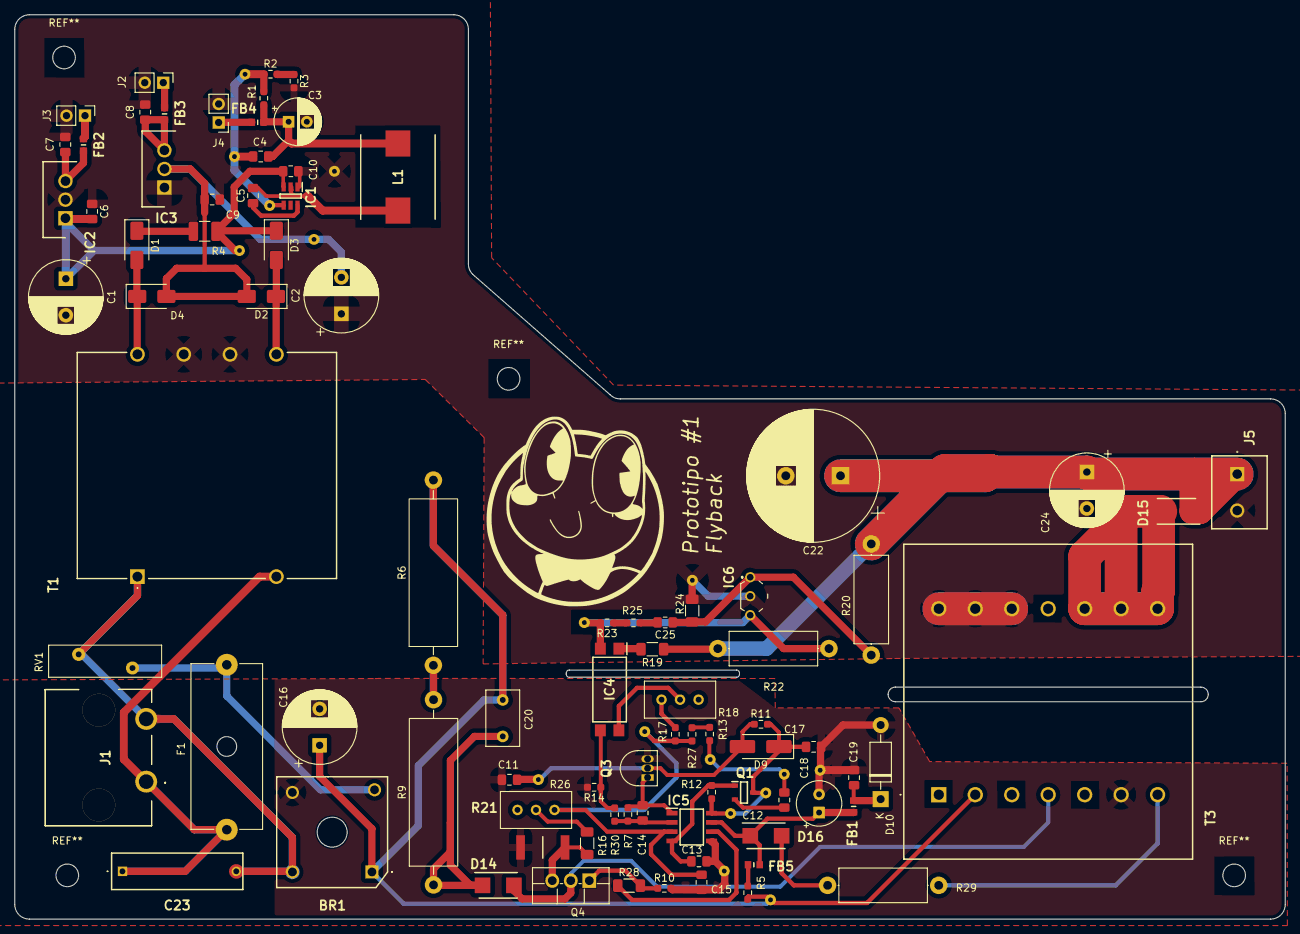
[picture p51: board Flyback_PCB_60Hz.kicad_pcb from above]

Board: 2 copper layers, 174.2 x 124.0 mm, 86 parts (0 on the bottom side), 52 nets.
