juamorenogo/DCSource_DIY/Electronic-design/General-Design/PCB/01_Digital-interface/Prototype_0THT/Digital_Interface/Digital_Interface.kicad_pcb

## KiCad design Electronic-design/General-Design/PCB/01_Digital-interface/Prototype_0THT/Digital_Interface/Digital_Interface.kicad_pcb (2026-06-08)

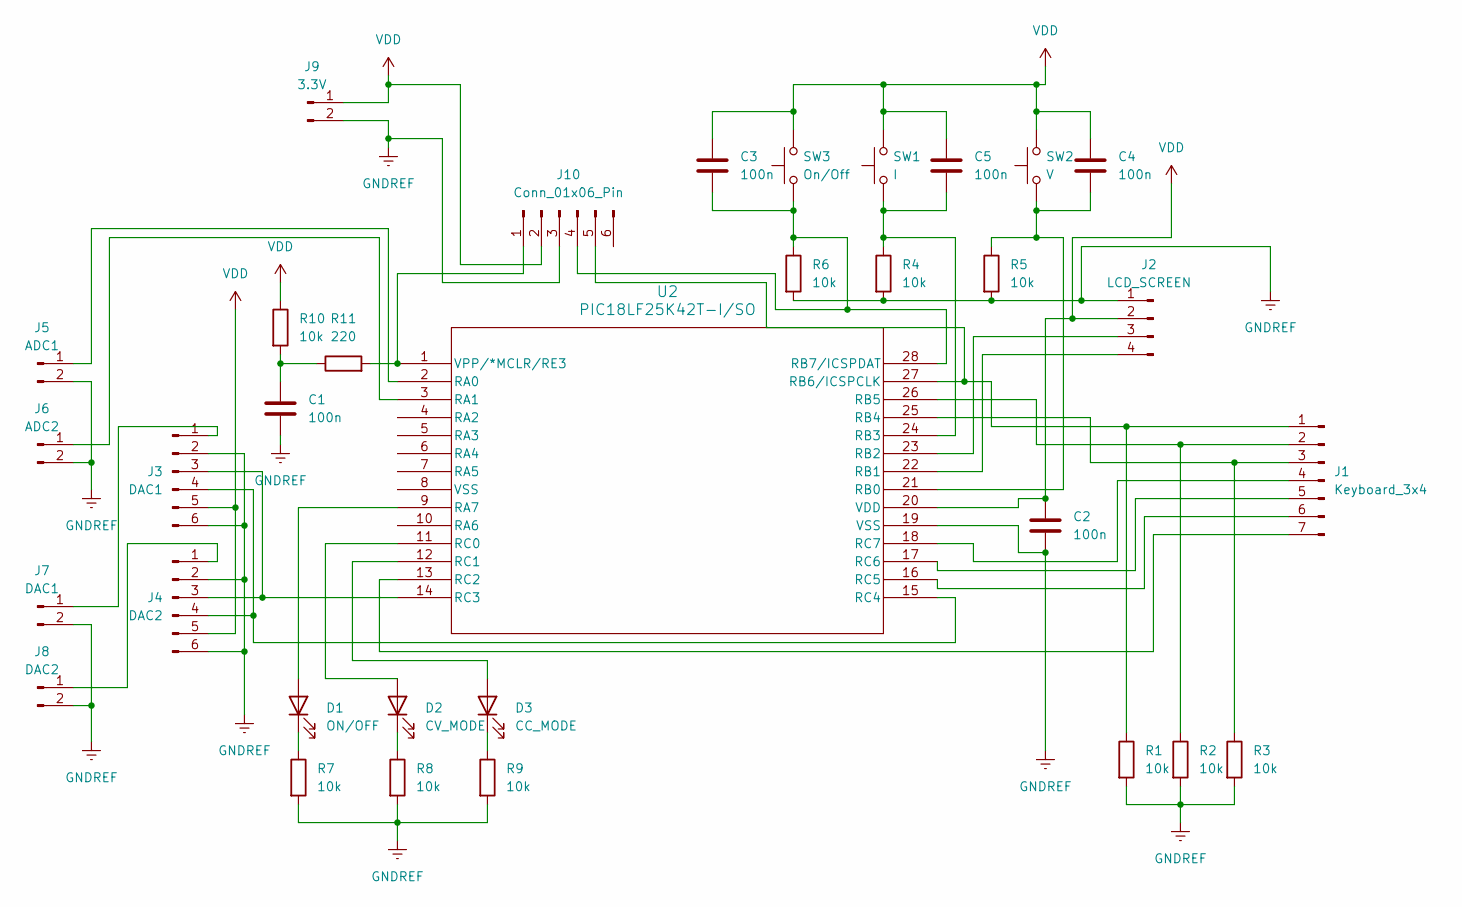
[picture p52: schematic Digital_Interface.kicad_sch]

Parts:
C1, C2, C3, C4, C5: 100n; C_Disc_D5.0mm_W2.5mm_P5.00mm
D1: ON/OFF; LED_D5.0mm
D2: CV_MODE; LED_D5.0mm
D3: CC_MODE; LED_D5.0mm
J1: Keyboard_3x4; PinHeader_1x07_P2.54mm_Vertical
J2: LCD_SCREEN; PinHeader_1x04_P2.54mm_Vertical
J3: DAC1; MCP4725_module
J4: DAC2; MCP4725_module
J5: ADC1; PinHeader_1x02_P2.54mm_Vertical
J6: ADC2; PinHeader_1x02_P2.54mm_Vertical
J7: DAC1; PinHeader_1x02_P2.54mm_Vertical
J8: DAC2; PinHeader_1x02_P2.54mm_Vertical
J9: 3.3V; PinHeader_1x02_P2.54mm_Vertical
J10: Conn_01x06_Pin; PinHeader_1x06_P2.54mm_Vertical
R1, R2, R3, R4, R5, R6, R7, R8, R9, R10: 10k; R_Axial_DIN0207_L6.3mm_D2.5mm_P7.62mm_Horizontal
R11: 220; R_Axial_DIN0207_L6.3mm_D2.5mm_P7.62mm_Horizontal
SW1: I; SW_PUSH_6mm
SW2: V; SW_PUSH_6mm
SW3: On/Off; SW_PUSH_6mm
U2: PIC18LF25K42T-I/SO; SOIC28_SO_MCH

Connections:
GNDREF: C1.2, C2.2, J2.1, J3.2, J3.6, J4.2, J4.6, J5.2, J6.2, J7.2, J8.2, J9.2, J10.3, R1.2, R2.2, R3.2, R4.2, R5.2, R6.2, R7.2, R8.2, R9.2, U2.19 (VSS)
unnamed: C1.1, R10.2, R11.1
unnamed: D1.2 (A), U2.9 (RA7)
unnamed: D1.1 (K), R7.1
unnamed: D2.2 (A), U2.11 (RC0)
unnamed: D2.1 (K), R8.1
unnamed: D3.2 (A), U2.12 (RC1)
unnamed: D3.1 (K), R9.1
unnamed: J1.1, J10.5, R1.1, U2.27 (RB6/ICSPCLK)
unnamed: J1.2, R2.1, U2.26 (RB5)
unnamed: J1.3, R3.1, U2.25 (RB4)
unnamed: J1.4, U2.18 (RC7)
unnamed: J1.5, U2.17 (RC6)
unnamed: J1.6, U2.16 (RC5)
unnamed: J1.7, U2.13 (RC2)
unnamed: J2.3, U2.23 (RB2)
unnamed: J2.4, U2.22 (RB1)
unnamed: J3.1, J7.1
unnamed: J3.3, J4.3, U2.14 (RC3)
unnamed: J3.4, J4.4, U2.15 (RC4)
unnamed: J4.1, J8.1
unnamed: J5.1, U2.2 (RA0)
unnamed: J6.1, U2.3 (RA1)
unnamed: J10.1, R11.2, U2.1 (VPP/*MCLR/RE3)
unnamed: C3.2, J10.4, R6.1, SW3.1, U2.28 (RB7/ICSPDAT)
unnamed: C4.2, R5.1, SW2.1, U2.21 (RB0)
unnamed: C5.2, R4.1, SW1.1, U2.24 (RB3)
VDD: C2.1, C3.1, C4.1, C5.1, J2.2, J3.5, J4.5, J9.1, J10.2, R10.1, SW1.2, SW2.2, SW3.2, U2.20 (VDD)

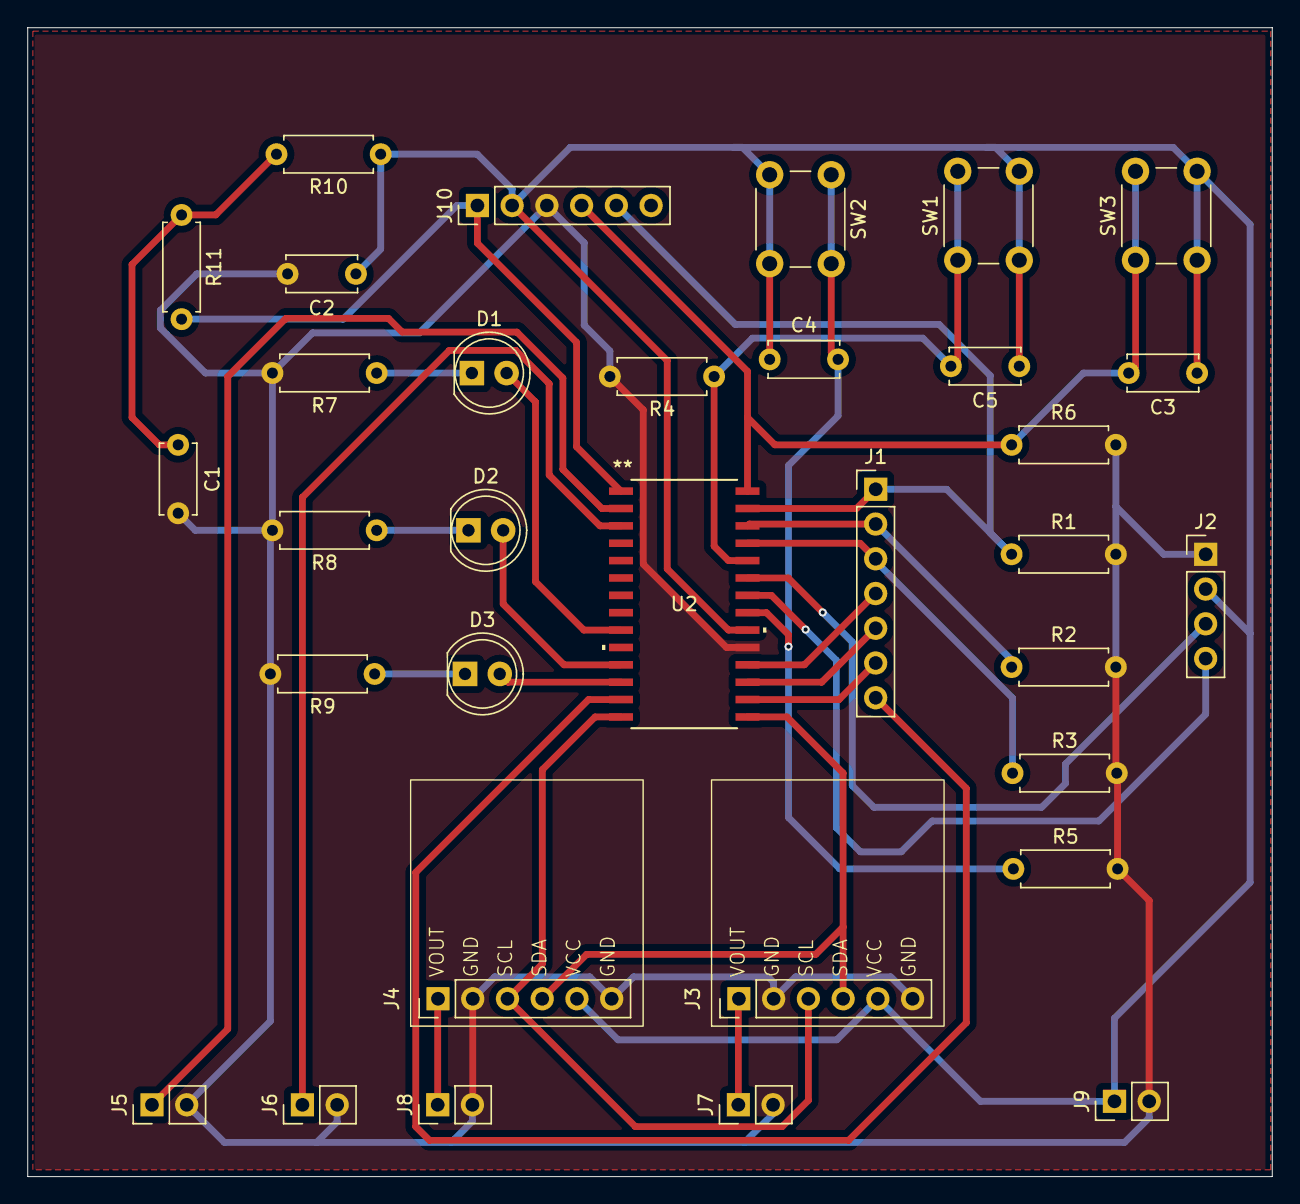
[picture p53: board Digital_Interface.kicad_pcb from above]

Board: 2 copper layers, 91.0 x 84.0 mm, 33 parts (0 on the bottom side), 28 nets.
