juamorenogo/DCSource_DIY/(commit log)

2026-04-07 Teoria para medicion de corriente 1
2026-04-07 Teoria para medicion de corriente 2
2026-04-23 Added protocolo de validacion.
2026-05-25 Al menos saca 30V :(
2026-05-26 Added digital interface
    [Digital_simulation.pdsprj]
2026-05-26 Added kiCad
    [Digital_Interface.kicad_pcb, Digital_Interface.kicad_sch]
2026-06-08 Added test digital interface PCB
    [Digital_Interface.kicad_pcb, Digital_Interface.kicad_sch, freerouting.dsn, temp-freerouting.dsn]
2026-07-19 Move PCB THT DigitalInterface 1
    [Digital_Interface.kicad_pcb, Digital_Interface.kicad_sch, freerouting.dsn, temp-freerouting.dsn]
2026-07-23 Schematic-1-Flyback + 60HZ
    [BEADC1608X95N.PcbLib, EDI2CAP.CFG, Flyback_PCB_60Hz.kicad_sch, MPZ1608R391ATD25.SchLib, MPZ1608R391ATD25.stp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]
